mixdowninc/i4lcdhsmc/hw/i4screenhsmc.brd

## EAGLE design hw/i4screenhsmc.brd (2014-08-26)

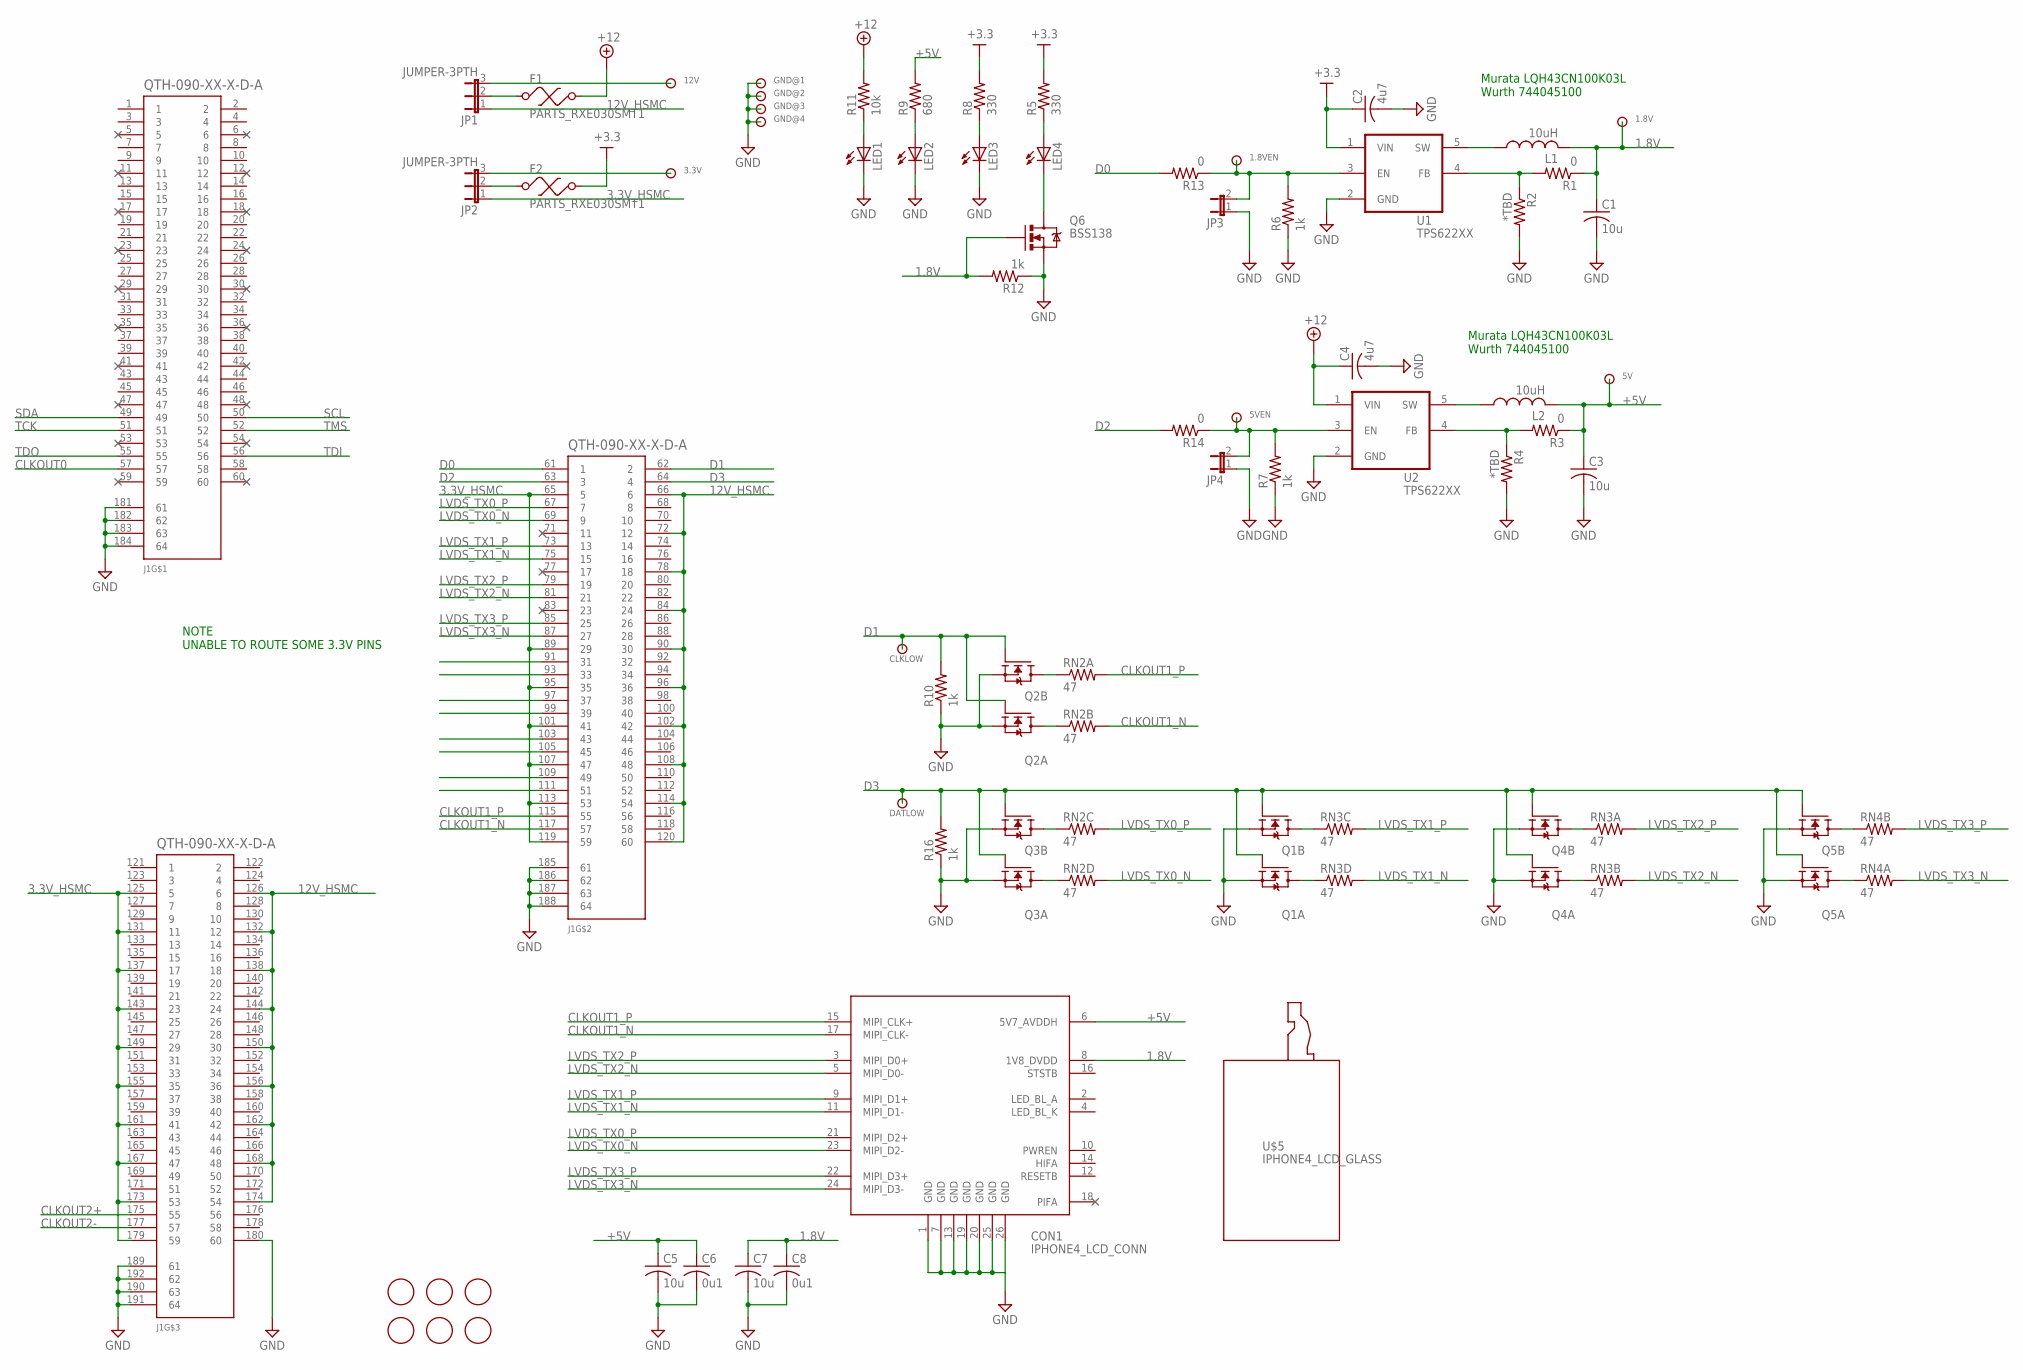
[picture p1: schematic i4screenhsmc.sch]

Parts:
1.8V, 5V: TESTPOINTKEYSTONE_5015; 5015
1.8VEN, 5VEN: TESTPOINTKEYSTONE_5016; 5016
3.3V, 12V: TESTPOINTBANANA_JACK; BANANA_JACK
C1, C3, C5, C7: 10u; C0805
C2, C4: 4u7; C0805
C6, C8: 0u1; C0805
CLKLOW: TESTPOINTKEYSTONE_5016; 5016
CON1: IPHONE4_LCD_CONN; AXE4E26124
DATLOW: TESTPOINTKEYSTONE_5016; 5016
F1, F2: PARTS_RXE030SMT1; POLYSWITCH_SMTSMALL
GND@1, GND@2: TESTPOINTBANANA_JACK; BANANA_JACK
GND@3, GND@4: TESTPOINTKEYSTONE_5015; 5015
J1: QTH-090-XX-X-D-A
JP1, JP2: JUMPER-3PTH; 1X03
JP3, JP4: JUMPER-2PTH; 1X02
L1, L2: 10uH; L1812
LED1, LED2, LED3, LED4: LEDCHIP-LED0805; CHIP-LED0805
Q1, Q2, Q3, Q4, Q5: 2N7002SC70-6; SC70-6
Q6: BSS138; SOT23-3
R1, R3, R13, R14: 0; R0805
R2, R4: *TBD; R0805
R5, R8: 330; R0805
R6, R7, R10, R12, R16: 1k; R0805
R9: 680; R0805
R11: 10k; R0805
RN2, RN3, RN4: 47; 2008
U1, U2: TPS622XX; SOT23-5
U$1, U$2, U$3, U$4, U$48, U$49: MOUNTING_HOLE125; HOLE_MTG_125
U$5: IPHONE4_LCD_GLASS; IPHONE4_LCD

Connections:
1.8V: 1.8V.P$1, C1.1, C7.1, C8.1, CON1.8 (1V8_DVDD), L1.2, Q6.1 (G), R1.1, R12.2
3.3V_HSMC: J1.65 (5), J1.89 (29), J1.95 (35), J1.101 (41), J1.107 (47), J1.113 (53), J1.119 (59), J1.125 (5), J1.131 (11), J1.137 (17), J1.143 (23), J1.149 (29), J1.155 (35), J1.161 (41), J1.167 (47), J1.173 (53), J1.179 (59), JP2.1
5VEN: 5VEN.P$1, JP4.2, R7.2, R14.1, U2.3 (EN)
12V_HSMC: J1.66 (6), J1.72 (12), J1.78 (18), J1.84 (24), J1.90 (30), J1.96 (36), J1.102 (42), J1.108 (48), J1.114 (54), J1.120 (60), J1.126 (6), J1.132 (12), J1.138 (18), J1.144 (24), J1.150 (30), J1.156 (36), J1.162 (42), J1.168 (48), J1.174 (54), JP1.1
+3.3: C2.1, F2.P$2 (2), R5.2, R8.2, U1.1 (VIN)
+5V: 5V.P$1, C3.1, C5.1, C6.1, CON1.6 (5V7_AVDDH), L2.2, R3.1, R9.2
+12: C4.1, F1.P$2 (2), R11.2, U2.1 (VIN)
CLKOUT0: J1.57
CLKOUT1_N: CON1.17 (MIPI_CLK-), J1.117 (57), RN2.7 (2)
CLKOUT1_P: CON1.15 (MIPI_CLK+), J1.115 (55), RN2.8 (2)
CLKOUT2+: J1.175 (55)
CLKOUT2-: J1.177 (57)
D0: J1.61 (1), R13.2
D1: CLKLOW.P$1, J1.62 (2), Q2.2 (G), Q2.5 (G), R10.2
D2: J1.63 (3), R14.2
D3: DATLOW.P$1, J1.64 (4), Q1.2 (G), Q1.5 (G), Q3.2 (G), Q3.5 (G), Q4.2 (G), Q4.5 (G), Q5.2 (G), Q5.5 (G), R16.2
GND: C1.2, C2.2, C3.2, C4.2, C5.2, C6.2, C7.2, C8.2, CON1.1 (GND), CON1.7 (GND), CON1.13 (GND), CON1.19 (GND), CON1.20 (GND), CON1.25 (GND), CON1.26 (GND), GND@1.1, GND@2.1, GND@3.P$1, GND@4.P$1, J1.180 (60), J1.181 (61), J1.182 (62), J1.183 (63), J1.184 (64), J1.185 (61), J1.186 (62), J1.187 (63), J1.188 (64), J1.189 (61), J1.190 (63), J1.191 (64), J1.192 (62), JP3.1, JP4.1, LED1.C, LED2.C, LED3.C, Q1.1 (S), Q1.4 (S), Q2.1 (S), Q2.4 (S), Q3.1 (S), Q3.4 (S), Q4.1 (S), Q4.4 (S), Q5.1 (S), Q5.4 (S), Q6.2 (S), R2.2, R4.2, R6.1, R7.1, R10.1, R12.1, R16.1, U1.2 (GND), U2.2 (GND)
LVDS_TX0_N: CON1.23 (MIPI_D2-), J1.69 (9), RN2.5 (2)
LVDS_TX0_P: CON1.21 (MIPI_D2+), J1.67 (7), RN2.6 (2)
LVDS_TX1_N: CON1.11 (MIPI_D1-), J1.75 (15), RN3.5 (2)
LVDS_TX1_P: CON1.9 (MIPI_D1+), J1.73 (13), RN3.6 (2)
LVDS_TX2_N: CON1.5 (MIPI_D0-), J1.81 (21), RN3.7 (2)
LVDS_TX2_P: CON1.3 (MIPI_D0+), J1.79 (19), RN3.8 (2)
LVDS_TX3_N: CON1.24 (MIPI_D3-), J1.87 (27), RN4.8 (2)
LVDS_TX3_P: CON1.22 (MIPI_D3+), J1.85 (25), RN4.7 (2)
unnamed: 1.8VEN.P$1, JP3.2, R6.2, R13.1, U1.3 (EN)
unnamed: L1.1, U1.5 (SW)
unnamed: L2.1, U2.5 (SW)
unnamed: LED4.A, R5.1
unnamed: Q1.6 (D), RN3.3 (1)
unnamed: F2.P$1 (1), JP2.2
unnamed: Q1.3 (D), RN3.4 (1)
unnamed: Q2.6 (D), RN2.1
unnamed: Q2.3 (D), RN2.2 (1)
unnamed: Q3.6 (D), RN2.3 (1)
unnamed: Q3.3 (D), RN2.4 (1)
unnamed: Q4.6 (D), RN3.1
unnamed: Q4.3 (D), RN3.2 (1)
unnamed: F1.P$1 (1), JP1.2
unnamed: R1.2, R2.1, U1.4 (FB)
unnamed: Q5.6 (D), RN4.2 (1)
unnamed: Q5.3 (D), RN4.1
unnamed: R3.2, R4.1, U2.4 (FB)
unnamed: 12V.1, JP1.3
unnamed: 3.3V.1, JP2.3
unnamed: LED3.A, R8.1
unnamed: LED2.A, R9.1
unnamed: LED1.A, R11.1
unnamed: LED4.C, Q6.3 (D)
SCL: J1.50
SDA: J1.49
TCK: J1.51
TDI: J1.56
TDO: J1.55
TMS: J1.52

Notes on the sheet:
Murata LQH43CN100K03L Wurth 744045100
NOTE UNABLE TO ROUTE SOME 3.3V PINS

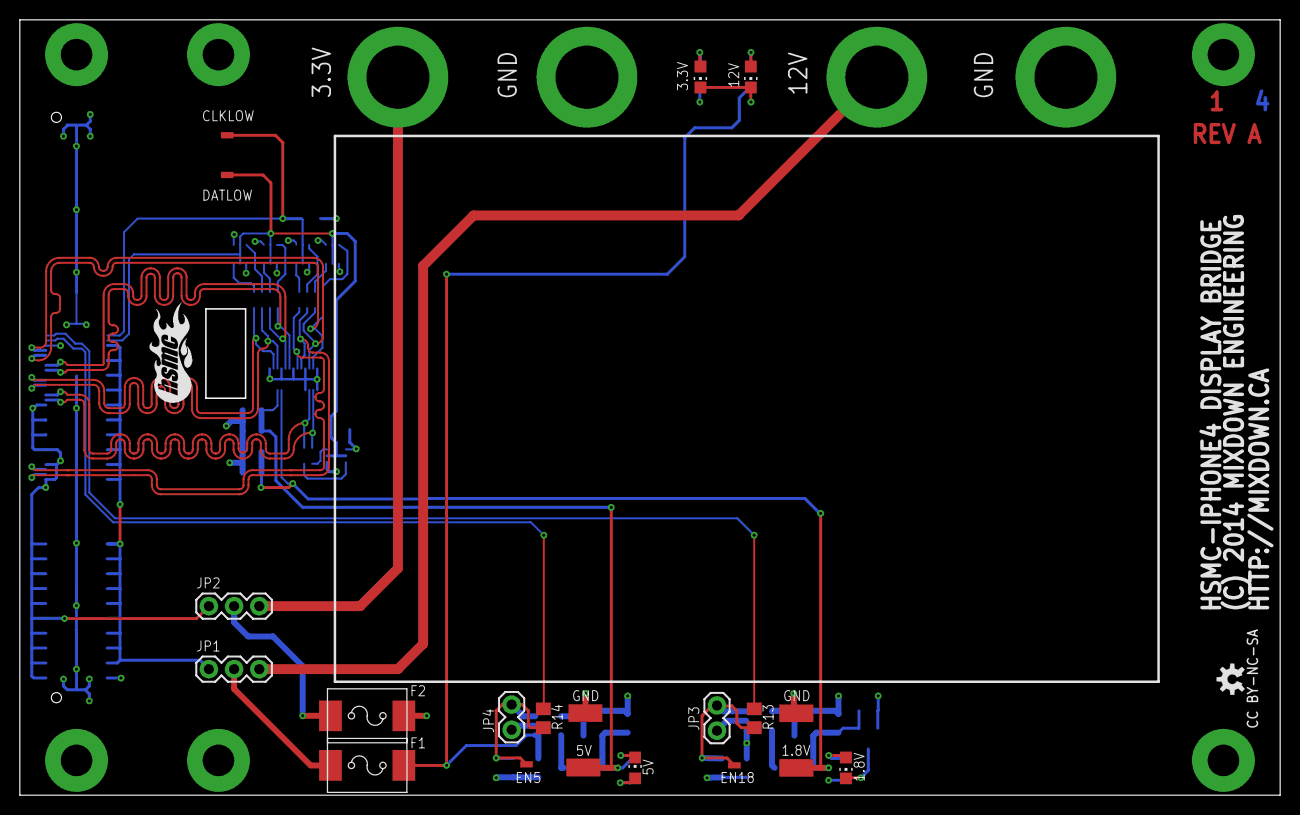
[picture p2: board i4screenhsmc.brd from above]

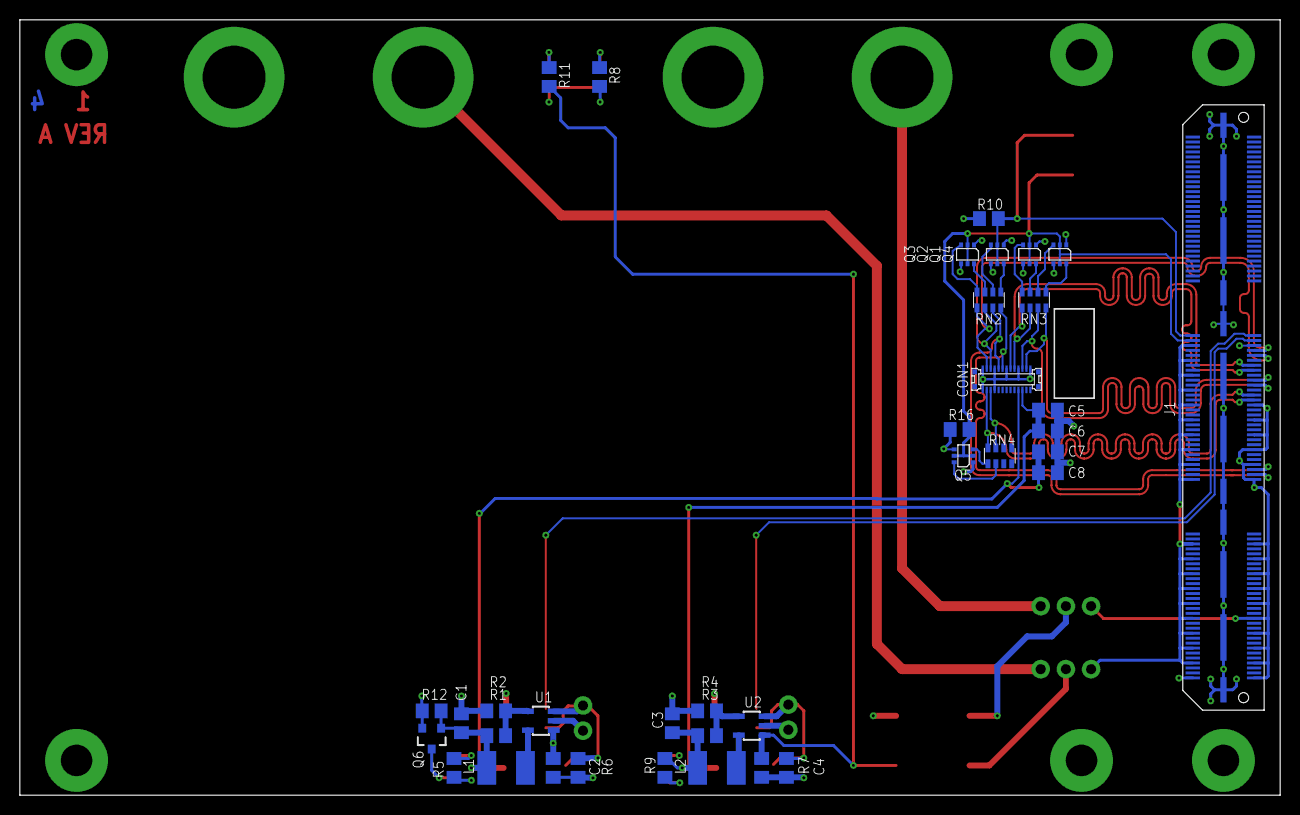
[picture p3: board i4screenhsmc.brd from below]

Board: 4 copper layers, 127.0 x 78.1 mm, 67 parts (36 on the bottom side), 46 nets.
