mixdowninc/i4lcdhsmc/(commit log)

2014-02-28 initial design
    [i4screenhsmc.brd, i4screenhsmc.sch]
2014-03-02 move hardware to hw directory
    [i4screenhsmc.brd, i4screenhsmc.sch]
2014-03-02 make MIPI traces 8mil wide but do not adjust spacing at all. This should be closer to 100 ohms differential, and beats ripping up all the copper and re-routing.
    [i4screenhsmc.brd]
2014-08-26 the N-channel FET is a BSS138, not a BSS84 (which is P-channel)
    [i4screenhsmc.brd, i4screenhsmc.sch]
