mixdowninc/i4lcdhsmc/(notices)

Notices in the files:
hw/i4screenhsmc.brd:
(C) 2014 MIXDOWN ENGINEERING
CC BY-NC-SA
parts and their libraries:
SparkFun: Licensing: CC v3.0 Share-Alike You are welcome to use this library for commercial purposes.
